nippoo/maxbox/electronics/v2/maxbox/maxbox.kicad_pcb

## KiCad design electronics/v2/maxbox/maxbox.kicad_pcb (2023-03-21)

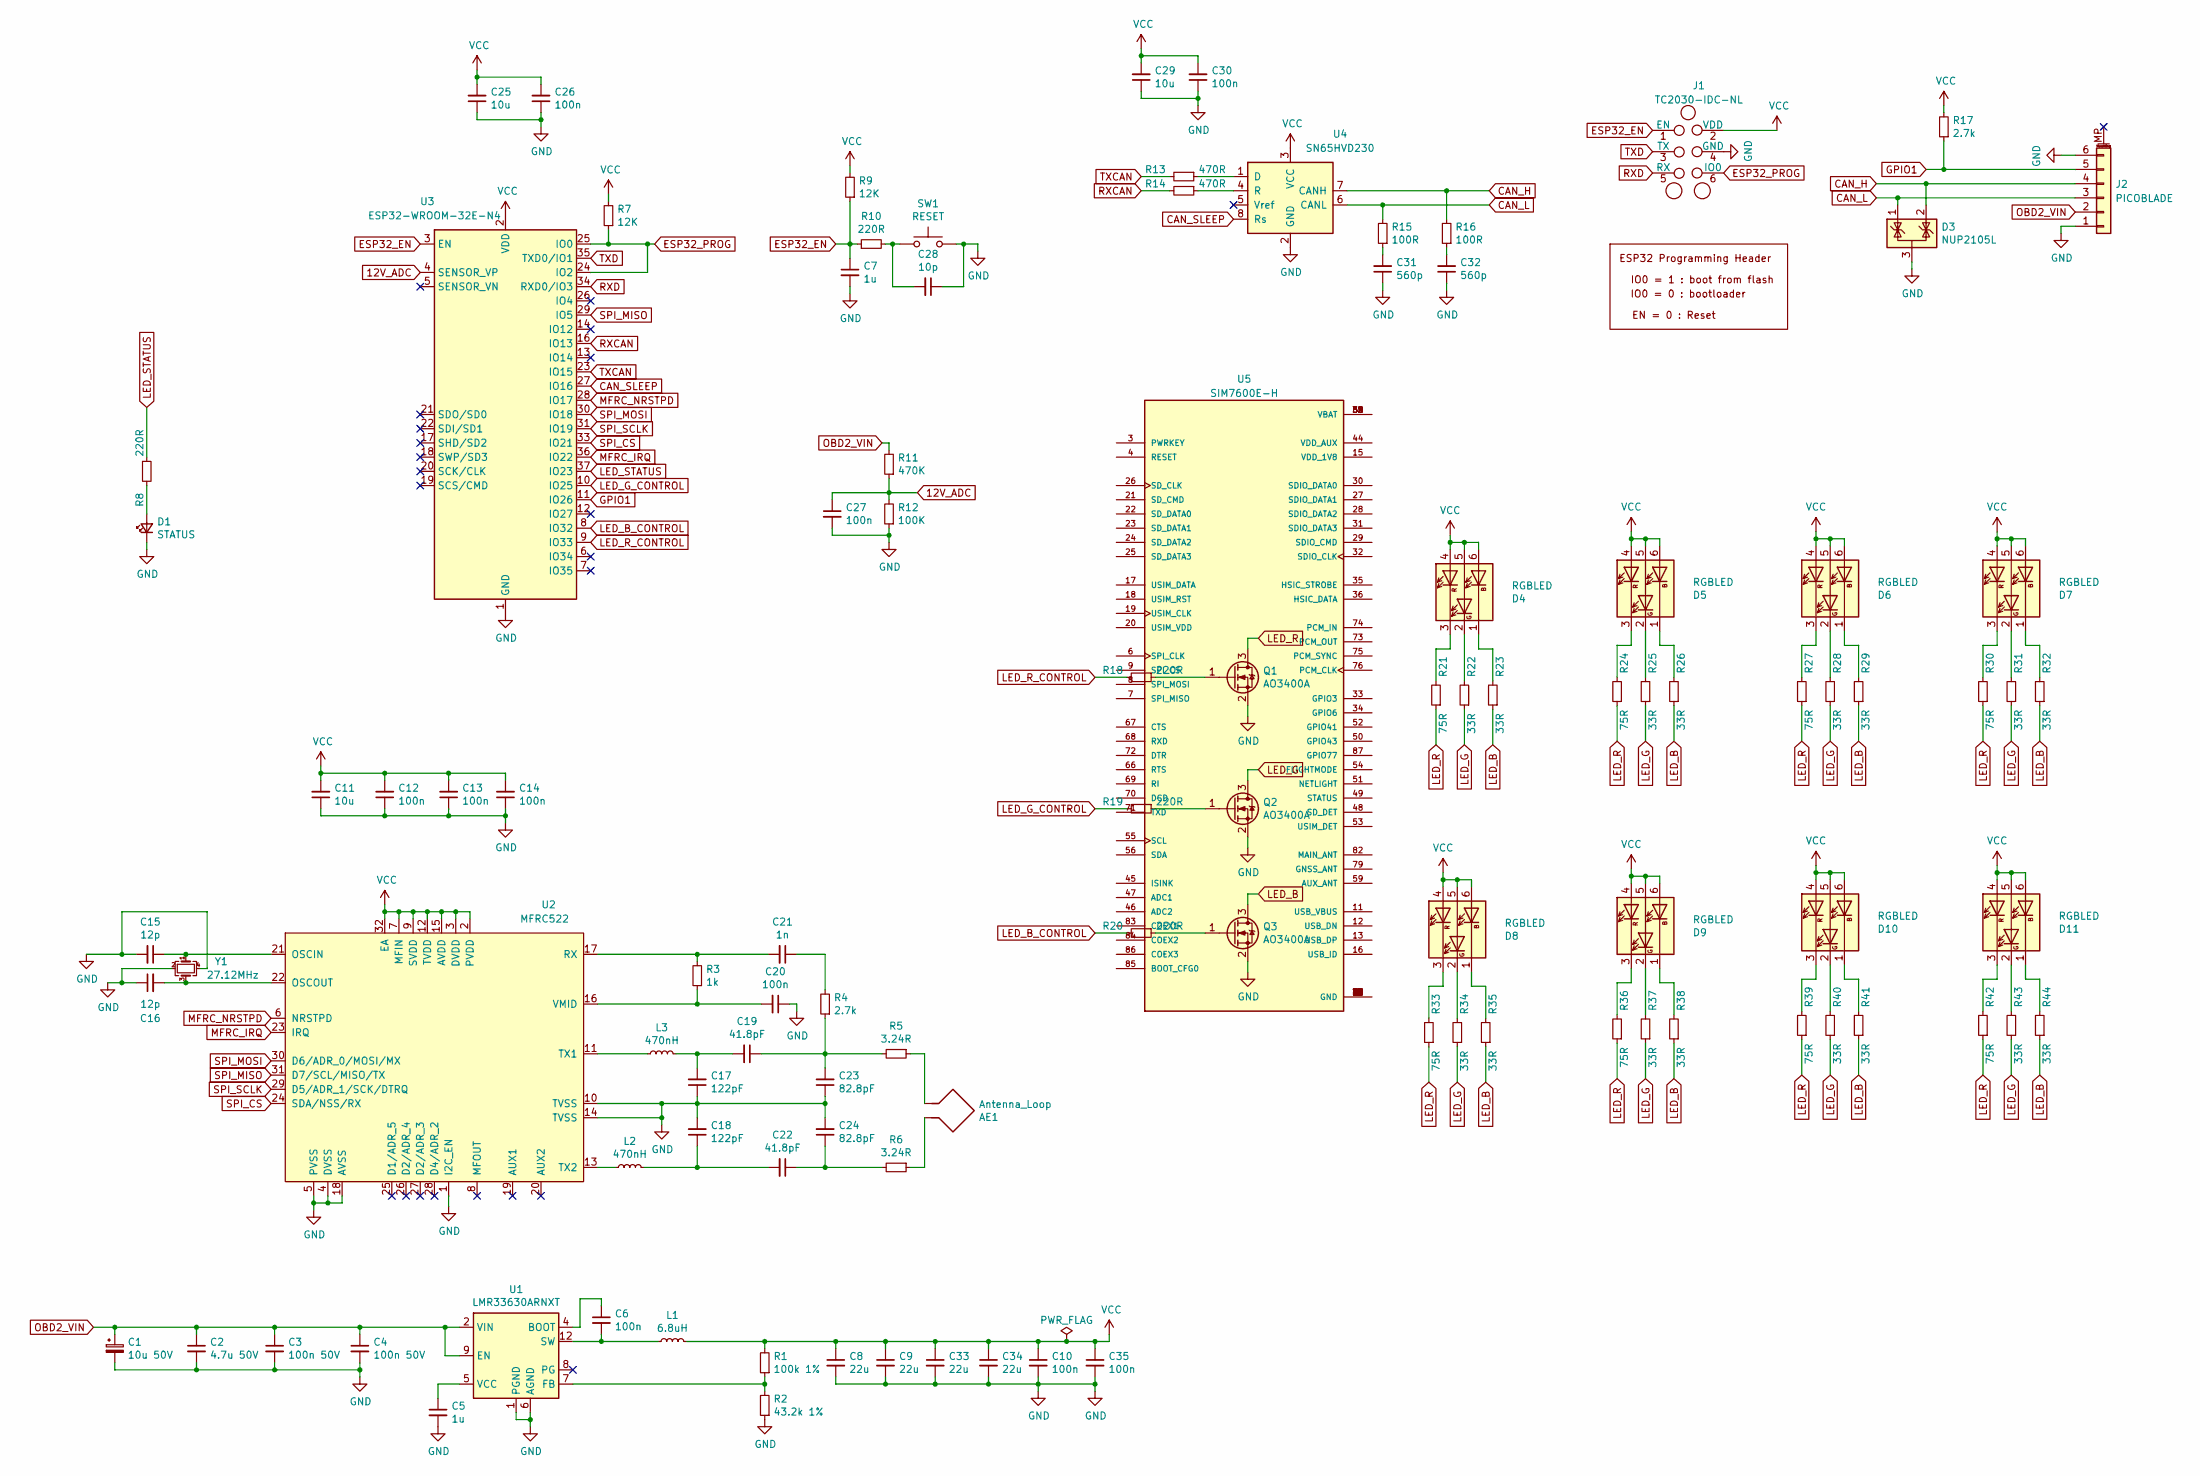
[picture p1: schematic maxbox.kicad_sch]

Parts:
AE1: Antenna_Loop; 95mm-3turn-antenna
C1: 10u 50V; C_0805_2012Metric; LCSC C440198
C2: 4.7u 50V; C_1206_3216Metric; LCSC C29823
C3, C4: 100n 50V; C_0402_1005Metric; LCSC C307331
C5, C7: 1u; C_0402_1005Metric; LCSC C52923
C6, C10, C12, C13, C14, C20, C26, C27, C30, C35: 100n; C_0402_1005Metric; LCSC C307331
C8, C9, C33, C34: 22u; C_0805_2012Metric; LCSC C45783
C11, C25, C29: 10u; C_0402_1005Metric; LCSC C15525
C15, C16: 12p; C_0805_2012Metric; LCSC C1792
C17, C18: 122pF; C_0603_1608Metric; LCSC C18438
C19, C22: 41.8pF; C_0805_2012Metric; LCSC C502147
C21: 1n; C_0402_1005Metric; LCSC C1523
C23, C24: 82.8pF; C_0805_2012Metric; LCSC C105942
C28: 10p; C_0402_1005Metric; LCSC C32949
C31, C32: 560p; C_0402_1005Metric; LCSC C1537
D1: STATUS; LED_0603_1608Metric; LCSC C72043
D3: NUP2105L; SOT-23; LCSC C284104
D4, D5, D6, D7, D8, D9, D10, D11: RGBLED; LED_FM-Z2727RGBA-SH; LCSC C727905
J1: TC2030-IDC-NL_ESP; Tag-Connect_TC2030-IDC-NL_2x03_P1.27mm_Vertical
J2: PICOBLADE; Molex_PicoBlade_53261-0671_1x06-1MP_P1.25mm_Horizontal; LCSC C99277
L1: 6.8uH; L_Cenker_CKST0603; LCSC C3002639
L2, L3: 470nH; L_0805_2012Metric; LCSC C655211
Q1, Q2, Q3: AO3400A; SOT-23; LCSC C20917
R1: 100k 1%; R_0402_1005Metric; LCSC C25741
R2: 43.2k 1%; R_0603_1608Metric; LCSC C23172
R3: 1k; R_0402_1005Metric; LCSC C11702
R4, R17: 2.7k; R_0603_1608Metric; LCSC C13167
R5, R6: 3.24R; R_0402_1005Metric; LCSC C270612
R7, R9: 12K; R_0402_1005Metric; LCSC C25752
R8, R10, R18, R19, R20: 220R; R_0402_1005Metric; LCSC C25091
R11: 470K; R_0402_1005Metric; LCSC C25790
R12: 100K; R_0402_1005Metric; LCSC C25741
R13, R14: 470R; R_0402_1005Metric; LCSC C25117
R15, R16: 100R; R_0402_1005Metric; LCSC C25076
R21, R24, R27, R30, R33, R36, R39, R42: 75R; R_0402_1005Metric; LCSC C25133
R22, R23, R25, R26, R28, R29, R31, R32, R34, R35, R37, R38, R40, R41, R43, R44: 33R; R_0402_1005Metric; LCSC C25105
SW1: RESET; XKB_TS-1187A-B-A-B; LCSC C318884
U1: LMR33630ARNXT; RNX0012B_VQFN-HR; LCSC C2861505
U2: MFRC522; VQFN-32-1EP_5x5mm_P0.5mm_EP3.5x3.5mm_ThermalVias; LCSC C11322
U3: ESP32-WROOM-32E-N4; ESP32-WROOM-32; LCSC C701341
U4: SN65HVD230; SOIC-8_3.9x4.9mm_P1.27mm; LCSC C12084
U5: SIM7600E-H; IC_SIM7600E-H; PARTREV 1.01
Y1: 27.12MHz; Crystal_SMD_3225-4Pin_3.2x2.5mm; LCSC C113669

Connections:
12V_ADC: C27.1, R11.1, R12.2, U3.4 (SENSOR_VP)
CAN_H: D3.2 (K), J2.4, R16.2, U4.7 (CANH)
CAN_L: D3.1 (K), J2.3, R15.2, U4.6 (CANL)
CAN_SLEEP: U3.27 (IO16), U4.8 (Rs)
ESP32_EN: C7.1, J1.1 (EN), R9.1, R10.1, U3.3 (EN)
ESP32_PROG: J1.6 (IO0), R7.1, U3.24 (IO2), U3.25 (IO0)
GND: C1.2, C2.2, C3.2, C4.2, C5.2, C7.2, C8.2, C9.2, C10.2, C11.1, C12.1, C13.1, C14.1, C15.2, C16.1, C17.1, C18.2, C20.1, C23.1, C24.2, C25.1, C26.1, C27.2, C28.1, C29.1, C30.1, C31.1, C32.1, C33.2, C34.2, C35.2, D1.1 (K), D3.3 (A), J1.4 (GND), J2.1, J2.6, Q1.2 (S), Q2.2 (S), Q3.2 (S), R2.1, R12.1, SW1.2, U1.1 (PGND), U1.6 (AGND), U1.11 (PGND), U2.1 (I2C_EN), U2.4 (DVSS), U2.5 (PVSS), U2.10 (TVSS), U2.14 (TVSS), U2.18 (AVSS), U3.1 (GND), U3.15 (GND), U3.38 (GND), U3.39 (GND), U4.2 (GND), Y1.2, Y1.4
GPIO1: J2.5, R17.1, U3.11 (IO26)
LED_B: Q3.3 (D), R23.1, R26.1, R29.1, R32.1, R35.1, R38.1, R41.1, R44.1
LED_B_CONTROL: R20.2, U3.8 (IO32)
LED_G: Q2.3 (D), R22.1, R25.1, R28.1, R31.1, R34.1, R37.1, R40.1, R43.1
LED_G_CONTROL: R19.2, U3.10 (IO25)
LED_R: Q1.3 (D), R21.1, R24.1, R27.1, R30.1, R33.1, R36.1, R39.1, R42.1
LED_R_CONTROL: R18.2, U3.9 (IO33)
LED_STATUS: R8.1, U3.37 (IO23)
MFRC_IRQ: U2.23 (IRQ), U3.36 (IO22)
MFRC_NRSTPD: U2.6 (NRSTPD), U3.28 (IO17)
unnamed: AE1.1, R6.1
unnamed: AE1.2, R5.1
unnamed: C5.1, U1.5 (VCC)
unnamed: C6.1, U1.4 (BOOT)
unnamed: C6.2, L1.1, U1.3 (NC), U1.12 (SW)
unnamed: C15.1, U2.21 (OSCIN), Y1.1
unnamed: C16.2, U2.22 (OSCOUT), Y1.3
unnamed: C17.2, C19.2, L3.2
unnamed: C18.1, C22.2, L2.2
unnamed: C19.1, C23.2, R4.1, R5.2
unnamed: C20.2, R3.1, U2.16 (VMID)
unnamed: C21.1, R4.2
unnamed: C21.2, R3.2, U2.17 (RX)
unnamed: C22.1, C24.1, R6.2
unnamed: C28.2, R10.2, SW1.1
unnamed: C31.2, R15.1
unnamed: C32.2, R16.1
unnamed: D1.2 (A), R8.2
unnamed: D4.1 (KB), R23.2
unnamed: D4.2 (KG), R22.2
unnamed: D4.3 (KR), R21.2
unnamed: D5.1 (KB), R26.2
unnamed: D5.2 (KG), R25.2
unnamed: D5.3 (KR), R24.2
unnamed: D6.1 (KB), R29.2
unnamed: D6.2 (KG), R28.2
unnamed: D6.3 (KR), R27.2
unnamed: D7.1 (KB), R32.2
unnamed: D7.2 (KG), R31.2
unnamed: D7.3 (KR), R30.2
unnamed: D8.1 (KB), R35.2
unnamed: D8.2 (KG), R34.2
unnamed: D8.3 (KR), R33.2
unnamed: D9.1 (KB), R38.2
unnamed: D9.2 (KG), R37.2
unnamed: D9.3 (KR), R36.2
unnamed: D10.1 (KB), R41.2
unnamed: D10.2 (KG), R40.2
unnamed: D10.3 (KR), R39.2
unnamed: D11.1 (KB), R44.2
unnamed: D11.2 (KG), R43.2
unnamed: D11.3 (KR), R42.2
unnamed: L2.1, U2.13 (TX2)
unnamed: L3.1, U2.11 (TX1)
unnamed: Q1.1 (G), R18.1
unnamed: Q2.1 (G), R19.1
unnamed: Q3.1 (G), R20.1
unnamed: R1.1, R2.2, U1.7 (FB)
unnamed: R13.1, U4.1 (D)
unnamed: R14.1, U4.4 (R)
unnamed: U5.1 (GND), U5.2 (GND), U5.5 (GND), U5.10 (GND), U5.14 (GND), U5.37 (GND), U5.40 (GND), U5.41 (GND), U5.43 (GND), U5.57 (GND), U5.58 (GND), U5.60 (GND), U5.61 (GND), U5.64 (GND), U5.65 (GND), U5.77 (GND), U5.78 (GND), U5.80 (GND), U5.81 (GND)
unnamed: U5.38 (VBAT), U5.39 (VBAT), U5.62 (VBAT), U5.63 (VBAT)
OBD2_VIN: C1.1, C2.1, C3.1, C4.1, J2.2, R11.2, U1.2 (VIN), U1.9 (EN), U1.10 (VIN)
RXCAN: R14.2, U3.16 (IO13)
RXD: J1.5 (RX), U3.34 (RXD0/IO3)
SPI_CS: U2.24 (SDA/NSS/RX), U3.33 (IO21)
SPI_MISO: U2.31 (D7/SCL/MISO/TX), U3.29 (IO5)
SPI_MOSI: U2.30 (D6/ADR_0/MOSI/MX), U3.30 (IO18)
SPI_SCLK: U2.29 (D5/ADR_1/SCK/DTRQ), U3.31 (IO19)
TXCAN: R13.2, U3.23 (IO15)
TXD: J1.3 (TX), U3.35 (TXD0/IO1)
VCC: C8.1, C9.1, C10.1, C11.2, C12.2, C13.2, C14.2, C25.2, C26.2, C29.2, C30.2, C33.1, C34.1, C35.1, D4.4 (AR), D4.5 (AG), D4.6 (AB), D5.4 (AR), D5.5 (AG), D5.6 (AB), D6.4 (AR), D6.5 (AG), D6.6 (AB), D7.4 (AR), D7.5 (AG), D7.6 (AB), D8.4 (AR), D8.5 (AG), D8.6 (AB), D9.4 (AR), D9.5 (AG), D9.6 (AB), D10.4 (AR), D10.5 (AG), D10.6 (AB), D11.4 (AR), D11.5 (AG), D11.6 (AB), J1.2 (VDD), L1.2, R1.2, R7.2, R9.2, R17.2, U2.2 (PVDD), U2.3 (DVDD), U2.7 (MFIN), U2.9 (SVDD), U2.12 (TVDD), U2.15 (AVDD), U2.32 (EA), U3.2 (VDD), U4.3 (VCC)

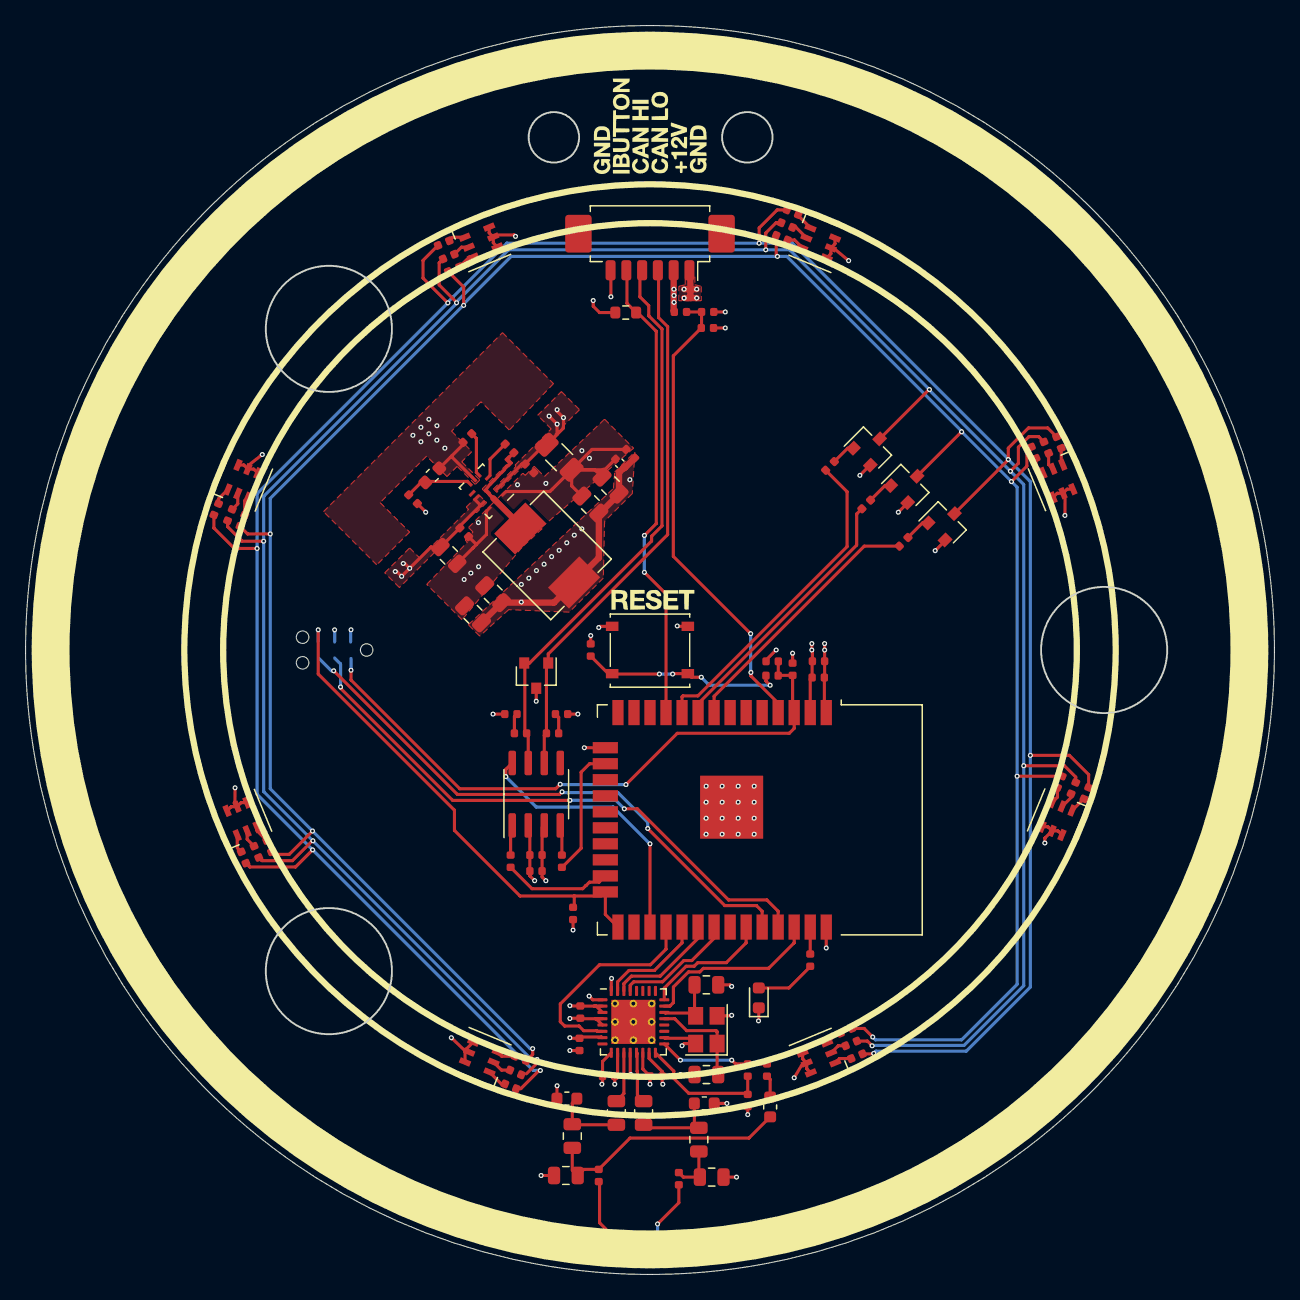
[picture p2: board maxbox.kicad_pcb from above]

Board: 4 copper layers, 99.0 x 99.0 mm, 104 parts (1 on the bottom side), 77 nets.
