nippoo/maxbox/(commit log)

2023-03-20 Removed LED telemetry heartbeat flash (driving distraction risk)
2023-03-20 Don't print WiFi password to console
2023-03-21 Enable OneWire debug print mode
2023-03-21 Created v2 electronics folder
    [maxbox.kicad_pcb, maxbox.kicad_sch]
2023-05-02 V11 firmware, minor CAN bus bugfixes
    [main.c, vehicle.c]
